Cyclocyclone/OpticniHRM/Poročilo/oscilator.png

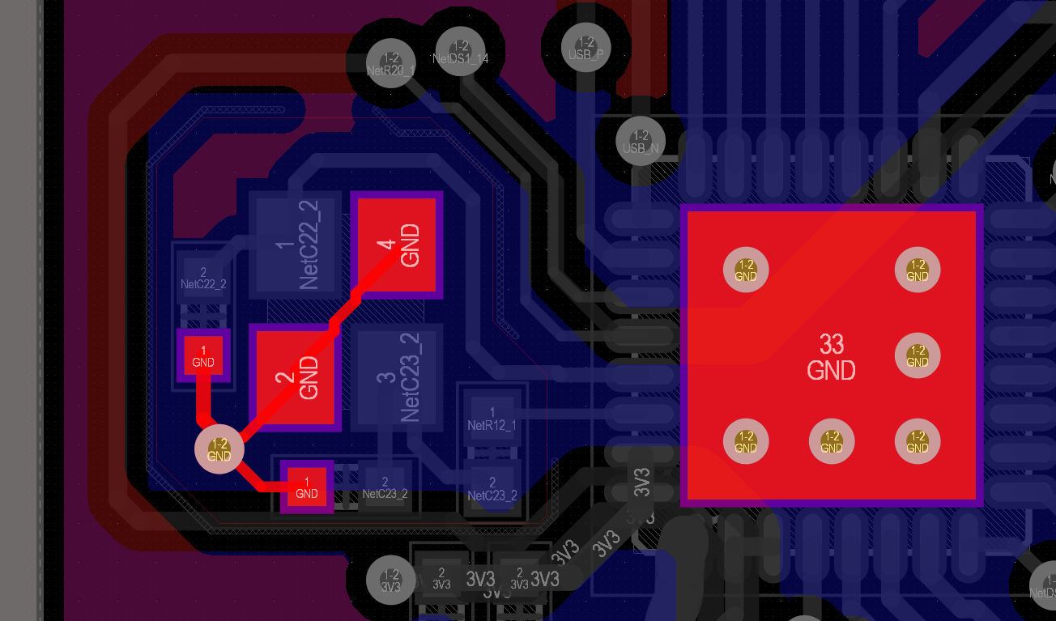
Poročilo/oscilator.png
