Cyclocyclone/OpticniHRM/Poročilo/OHRMPrincip.jpg

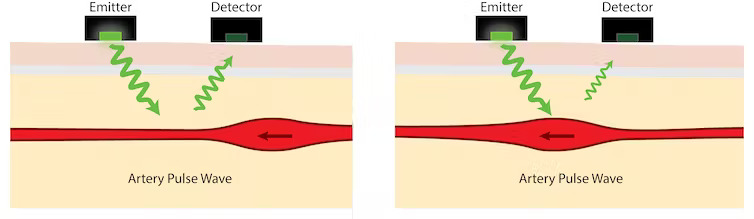
Poročilo/OHRMPrincip.jpg
