Cyclocyclone/OpticniHRM/README.md

# OpticniHRM
Wearable HRM in SpO2 monitor z prikazom na E-ink zaslonu in moznostjo povezave preko BT in WiFi.
