Cyclocyclone/OpticniHRM/Poročilo/MeritveKolo.pdf

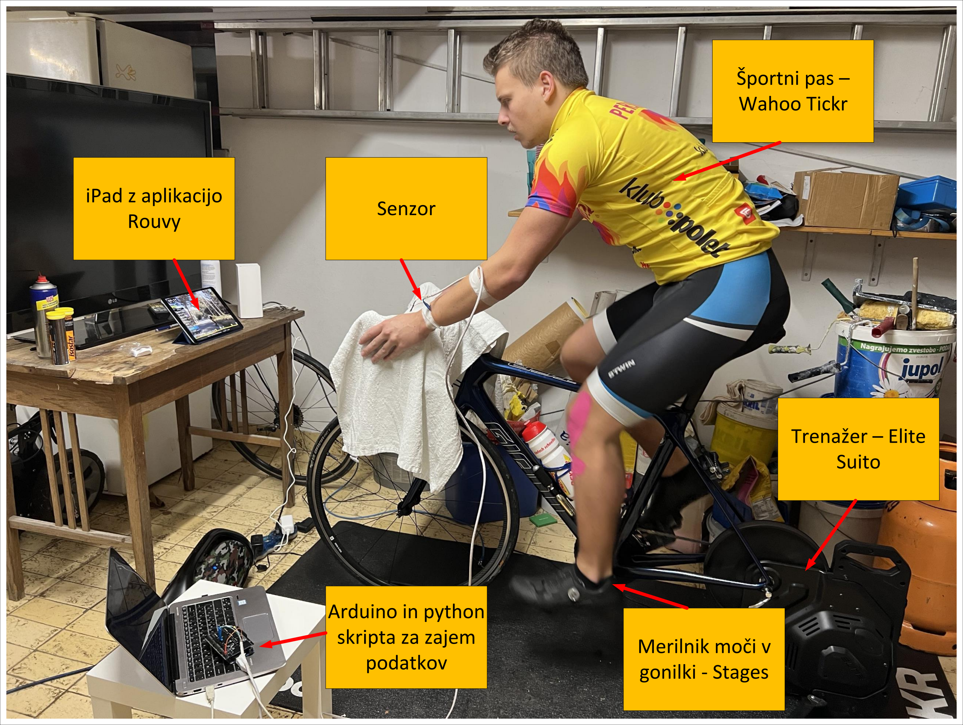
[picture p3: page 1]

Trenažer – Elite
Suito

Merilnik moči v
gonilki - Stages

Senzor

Športni pas –
Wahoo Tickr

Arduino in python
skripta za zajem
podatkov

iPad z aplikacijo
Rouvy
