Cyclocyclone/OpticniHRM/Poročilo/Blokshema.pdf

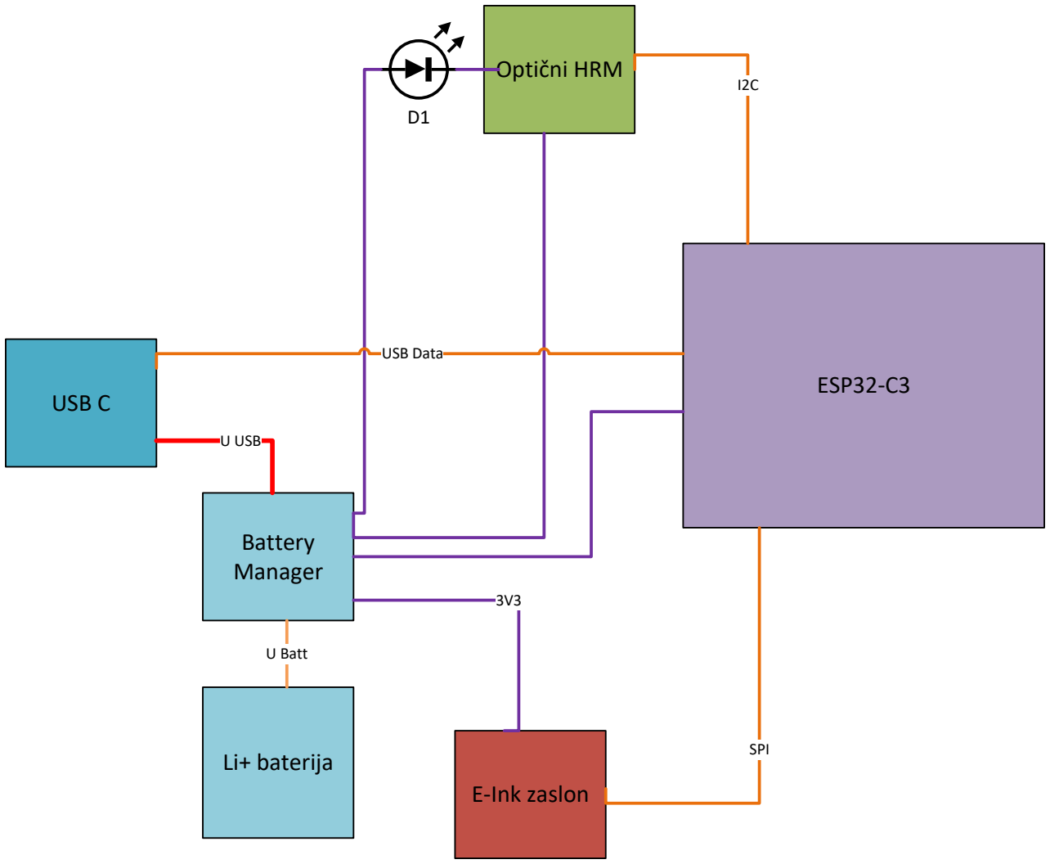
[picture p4: figure]
USB C; ESP32-C3; Battery Manager; E-Ink zaslon; Optični HRM; U USB; Li+ baterija; U Batt; USB Data; SPI
