Cyclocyclone/OpticniHRM/PythonKoda/images/fig1.pdf

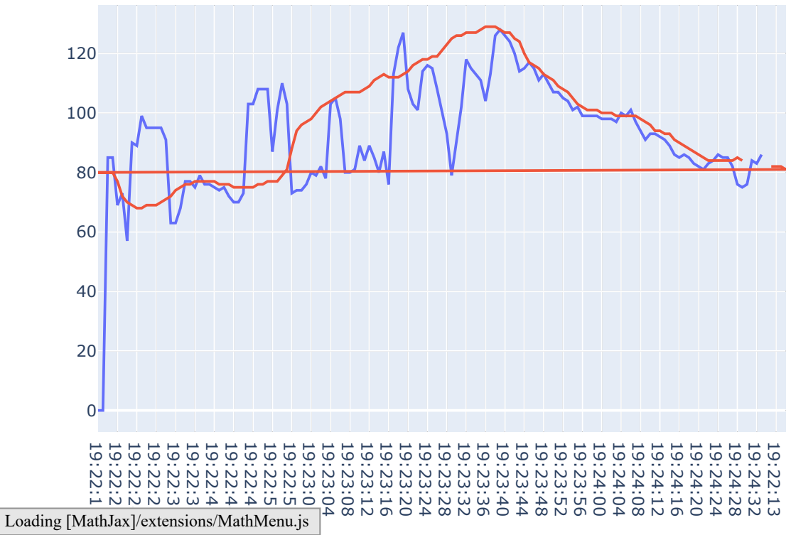
[picture p5: figure]
Loading [MathJax]/extensions/MathMenu.js

OHRM
Pas

## Primerjava senzorjev
