Cyclocyclone/OpticniHRM/PythonKoda/images/Roka.pdf

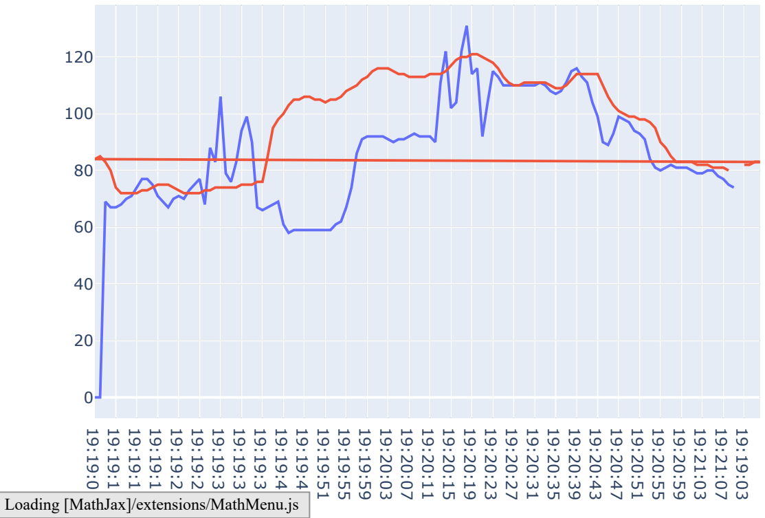
[picture p6: figure]
Loading [MathJax]/extensions/MathMenu.js

OHRM
Pas

## Senzor in pas na roki
