Cyclocyclone/OpticniHRM/PythonKoda/images/Zapestje.pdf

Loading [MathJax]/extensions/MathMenu.js

OHRM
Pas

## Senzor in pas na zapestju
