Cyclocyclone/OpticniHRM/Poročilo/antena.png

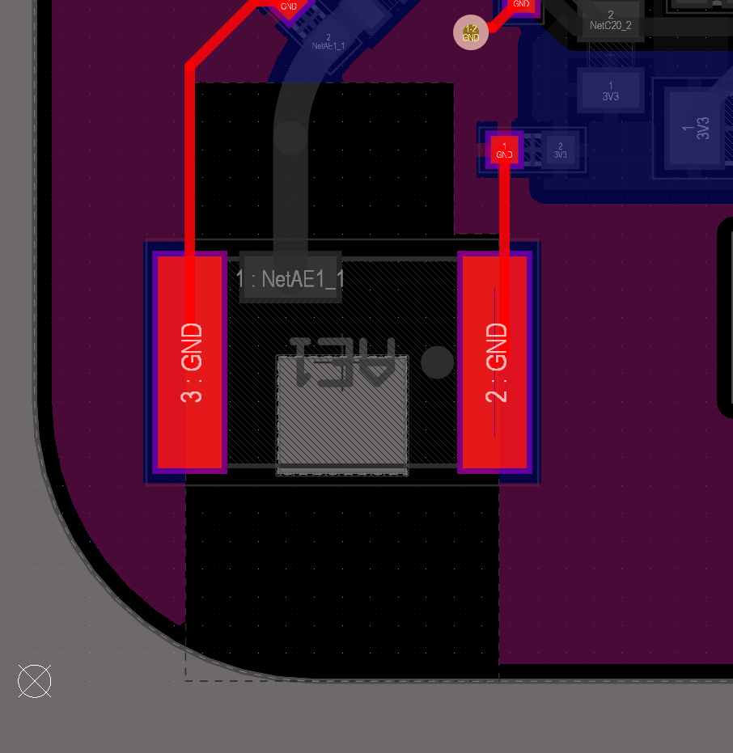
Poročilo/antena.png
