Cyclocyclone/OpticniHRM/Poročilo/DimenzijePCB.png

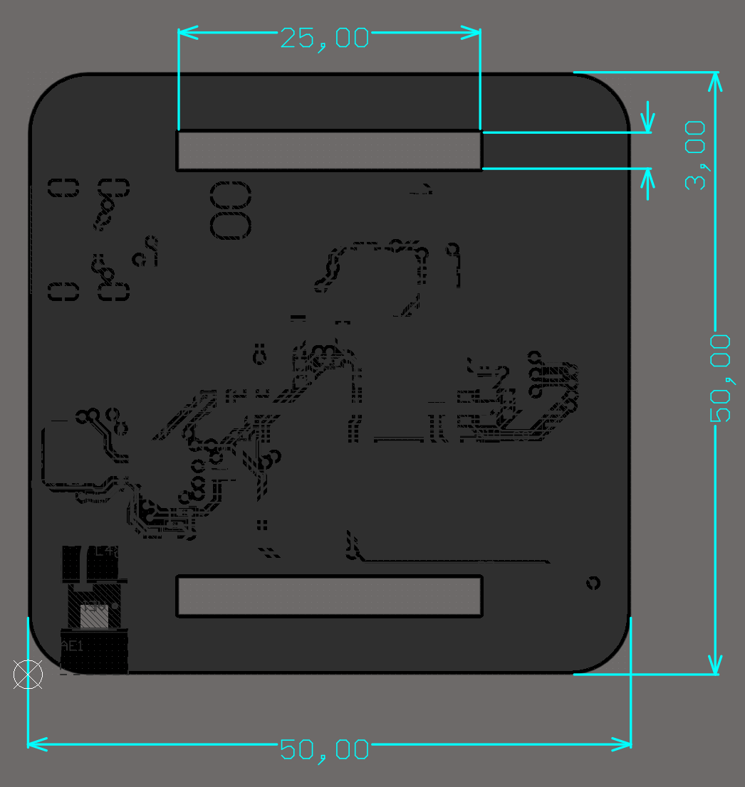
Poročilo/DimenzijePCB.png
