Cyclocyclone/OpticniHRM/Poročilo/DIsplayPSU.png

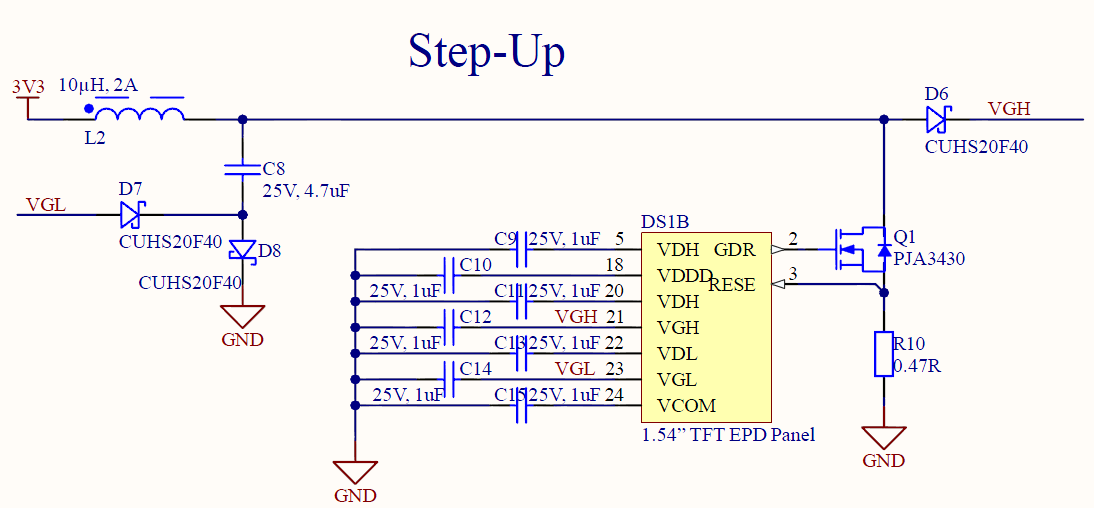
Poročilo/DIsplayPSU.png
