Cyclocyclone/OpticniHRM/Poročilo/imedancecontroled.png

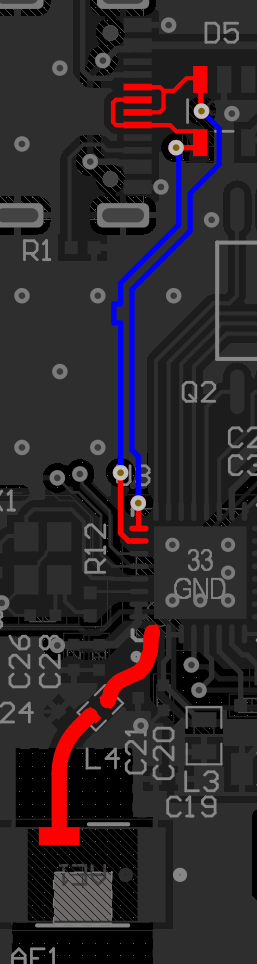
Poročilo/imedancecontroled.png
