Cyclocyclone/OpticniHRM/Poročilo/LokacijaSenzor.png

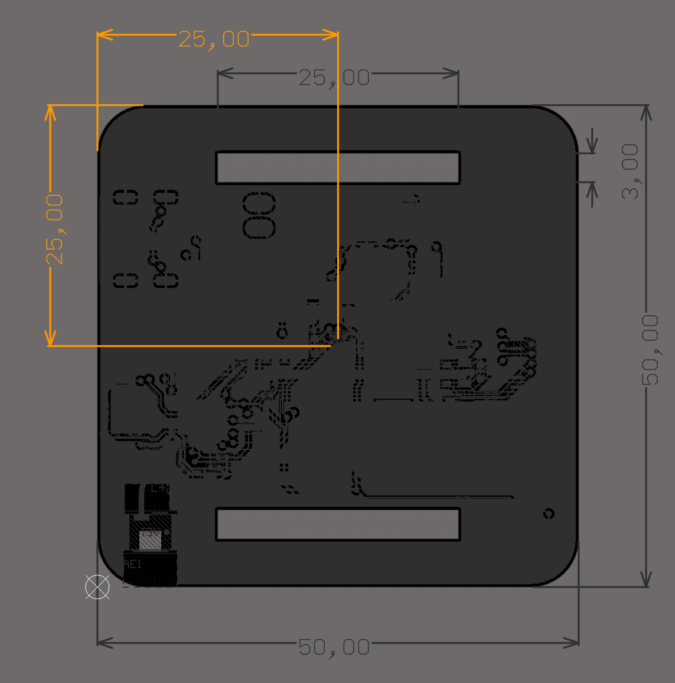
Poročilo/LokacijaSenzor.png
