Cyclocyclone/OpticniHRM/Poročilo/PSU.png

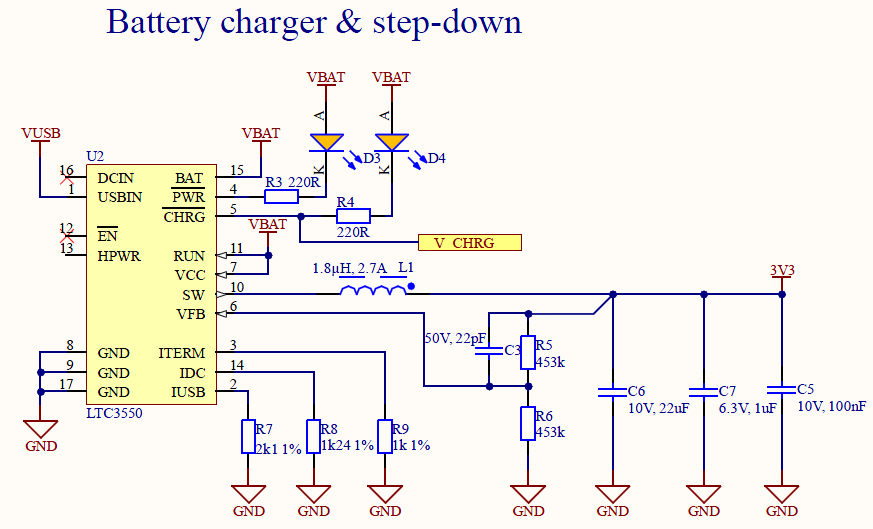
Poročilo/PSU.png
