Cyclocyclone/OpticniHRM/Poročilo/senzor.png

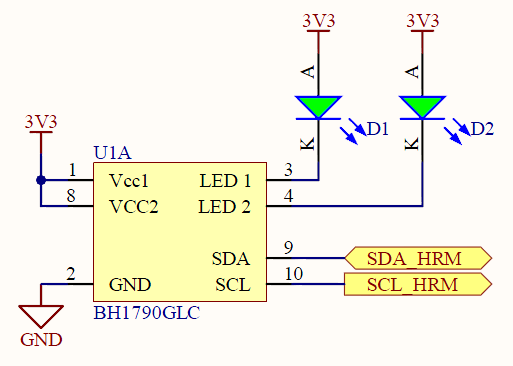
Poročilo/senzor.png
