Cyclocyclone/OpticniHRM/Poročilo/Trenazer.png

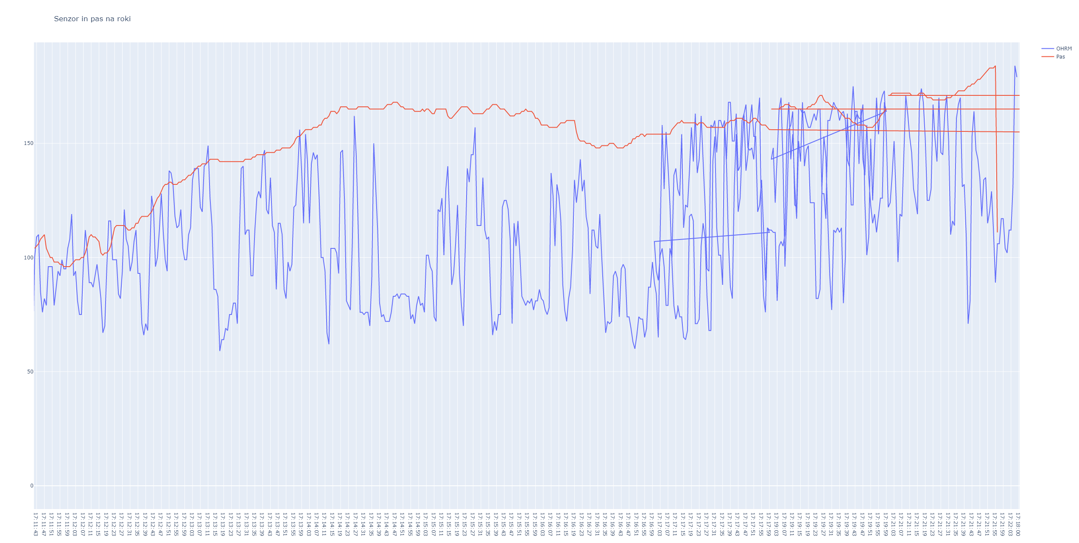
Poročilo/Trenazer.png
