Cyclocyclone/OpticniHRM/Poročilo/Varnost.png

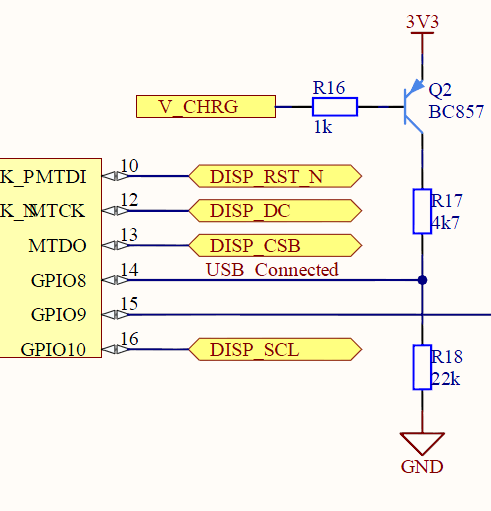
Poročilo/Varnost.png
