Cyclocyclone/OpticniHRM/Opticni HRM/Project Outputs for Opticni HRM/Opticni HRM.xlsx

Comment | Description | Designator | Footprint | LibRef | Quantity | Value | Mouser Code | Farnell code
7488960245 | WE-MCA SMT Multilayer Chip Antenna, 1 Band, 2400-2500MHz, 50Ω | AE1 | 7488960245 | 7488960245 | 1 |  | 710-7488960245
Battery To be changed |  | B1 | letev2 | header2 | 1
16V, 100nF | WCAP-CSGP Ceramic Capacitors, 0603, X7R, 16V, 100nF | C1 | 0603_1.6x0.8x0.8mm_Reflow Soldering | 885012206046 | 1 | 100nF | 710-885012206046
10V, 2.2uF | WCAP-CSGP Ceramic Capacitors, 0603, X7R, 10V, 2.2uF | C2 | 0603_1.6x0.8x0.8mm_Reflow Soldering | 885012206027 | 1 | 2.2uF | 710-885012206027
50V, 22pF | WCAP-CSGP Ceramic Capacitors, 0402, NP0, 50V, 22pF | C3 | 0402_1x0.5x0.5mm | 885012005057 | 1 | 22pF | 710-885012005057
10V, 4.7uF | WCAP-CSGP Ceramic Capacitors, 0603, X5R, 10V, 4.7uF | C4 | 0603_1.6x0.8x0.8mm_Reflow Soldering | 885012106012 | 1 | 4.7uF | 710-885012106012
10V, 100nF | WCAP-CSGP Ceramic Capacitors, 0603, X7R, 10V, 100nF | C5 | 0603_1.6x0.8x0.8mm_Reflow Soldering | 885012206020 | 1 | 100nF | 710-885012206020
10V, 22uF | WCAP-CSGP Ceramic Capacitors, 0805, X5R, 10V, 22uF | C6, C18 | 0805_2x1.25x1.25mm_Reflow Soldering | 885012107011 | 2 | 22uF | 710-885012107011
6.3V, 1uF | WCAP-CSGP Ceramic Capacitors, 0603, X5R, 6.3V, 1uF | C7 | 0603_1.6x0.8x0.8mm_Reflow Soldering | 885012106003 | 1 | 1uF | 710-885012106003
25V, 4.7uF | WCAP-CSGP Ceramic Capacitors, 0805, X5R, 25V, 4.7uF | C8 | 0805_2x1.25x1.25mm_Reflow Soldering | 885012107018 | 1 | 4.7uF | 710-885012107018
25V, 1uF | WCAP-CSGP Ceramic Capacitors, 0603, X5R, 25V, 1uF | C9, C10, C11, C12, C13, C14, C15, C16 | 0603_1.6x0.8x0.8mm_Reflow Soldering | 885012106022 | 8 | 1uF | 710-885012106022
25V, 100nF | WCAP-CSGP Ceramic Capacitors, 0402, X5R, 25V, 100nF | C17, C19, C20, C25, C27, C29 | 0402_1x0.5x0.5mm | 885012105018 | 6 | 100nF | 710-885012105018
TBD | WCAP-CSGP Ceramic Capacitors, 0402, NP0, 16V, 2.2pF | C21, C22, C23, C24 | 0402_1x0.5x0.5mm | 885012005021 | 4 | 2.2pF | 710-885012005021
10V, 1uF | WCAP-CSGP Ceramic Capacitors, 0402, X5R, 10V, 1uF | C26, C30 | 0402_1x0.5x0.5mm | 885012105012 | 2 | 1uF | 710-885012105012
10V, 10nF | WCAP-CSGP Ceramic Capacitors, 0402, X7R, 10V, 10nF | C28 | 0402_1x0.5x0.5mm | 885012205012 | 1 | 10nF | 710-885012205012
Bright Green, 2V, 140° | WL-SMCW Mono-color Chip LED Waterclear, SMT, size 0603, Bright Green, 2V, 140° | D1, D2 | WL-SMCW_0603_150060xx75003 | 150060VS75003 | 2 |  | 710-150060VS75003
Amber, 2V, 140° | WL-SMCW Mono-color Chip LED Waterclear, SMT, size 0603, Amber, 2V, 140° | D3, D4 | WL-SMCW_0603_150060xx75000 | 150060AS75000 | 2 |  | 710-150060AS75000
5V | WE-TVS TVS Diode – High Speed Series, SOT23-5L, 2+1 Channel, 5V, 2pF | D5 | WE-TVS_SOT23-5L | 824011 | 1 |  | 710-824011
CUHS20F40 | Schottky Barrier Diode Silicon Epitaxia | D6, D7, D8 | Topshiba US2H | CUHS20F40 | 3 |  | 757-CUHS20F40H3F
Green, 3.2V, 140° | WL-SMCW Mono-color Chip LED Waterclear, SMT, size 0603, Green, 3.2V, 140° | D9 | WL-SMCW_0603_150060xx75003 | 150060GS75003 | 1 |  | 710-150060GS75003
1.54” TFT EPD Panel | Wurth 687124183622 connector | DS1 | 687124183622 | E2154CS0C1 | 1 |  | 341-E2154CS0C1
USB C connector | USB4105-15-A-120 | J1 | USB4105-15-A-120 | USB4105-15-A-120 | 1 |  | 640-USB4105-GF-A
1.8µH, 2.7A | WE-TPC SMT Tiny Power Inductor, 4828, 1.8µH, 2.7A, 25mΩ | L1 | WE-TPC_4828 | 7440430018 | 1 |  | 710-7440430018
10µH, 2A | WE-TPC SMT Tiny Power Inductor, 8020, 10µH, 2A, 94mΩ | L2 | WE-TPC_8020 | 7440700100 | 1 |  | 710-7440700100
2nH, 1.9A |  | L3 | 0603CT SERIES | 0603CT-2N0XJRW | 1 |  | 994-0603CT-2N0XJRW
TBD | 0402 Coil - Coilcraft | L4 | 0402CS SERIES | 0402CT | 1
PJA3430 | 20V/2A N-Channel Enhancment Mode MOSFET | Q1 | SOT23 | PJA3430_R1_00001 | 1 |  | 241-PJA3430_R1_00001
BC857 |  | Q2 | SOT23 | BC857 | 1 |  | 771-BC857BMB315
Res2-smd |  | R1, R2 | R0402 | Res2-smd | 2 | 36k | 667-ERJ-2RKF3602X
220R |  | R3, R4, R20 | R0402 | Res 0402 | 3 | 220R | 71-CRCW0402220RFKEDC
Res2-smd |  | R5, R6 | R0402 | Res2-smd | 2 | 453k | 660-RK73H1ETTP4533F
Res2-smd |  | R7 | R0402 | Res2-smd | 1 | 2k1 1% | 652-CR0402-FX2101GLF
Res2-smd |  | R8 | R0402 | Res2-smd | 1 | 1k24 1% | 652-CR0402-FX1241GLF
Res2-smd |  | R9, R16 | R0402 | Res2-smd | 1 | 1k 1% | 603-RC0402FR-101KL
Res2-smd |  | R10 | RES0805_1 | Res2-smd | 1 | 0.47R | 667-ERJ-U6QFR47V
10k |  | R11, R13, R14, R15, R19 | R0402 | Res 0402 | 5 | 10k | 603-AC0402FR-7W10KL
TBD |  | R12 | R0402 | Res 0402 | 1
4k7 |  | R17 | R0402 | Res 0402 | 1 | 4k7 | 603-RC0402FR-7D4K7L
22k |  | R18 | R0402 | Res 0402 | 1 | 22k | 71-CRCW0402-22K-E3
435151014845 | WS-TASV SMT Tact Switch with ground terminal, SPST-NO, 12VDC, 50mA, 450g | SW1 | WS-TASV_L3W2.6H1.4_4351x10148xx | 435151014845 | 1 |  | 710-435151014845
BH1790GLC | Optical Sensor for Heart Rate Monitor IC | U1 | WLGA010V28_ROHM | BH1790GLC | 1 |  | 755-BH1790GLC-E2
LTC3550 | Dual Input USB/AC Adapter Li-Ion Battery Charger with 600mA Buck Converter | U2 | DHC16 Linear | LTC3550 | 1 |  | 584-LTC3550EDHC-1PBF
ESP32-C3 | Ultra-Low-Power SoC with RISC-V Single-Core CPU Supporting IEEE 802.11b/g/n (2.4 GHz Wi-Fi) and Bluetooth® 5 (LE) | U3 | 32L SLP Expressif | ESP32-C3 | 1 |  | 356-ESP32-C3FN4
AT25SF041B | 4-Mbit SPI Serial Flash Memory with Dual-I/O and Quad-I/O Support | U4 | SOIC8 Wide dialog semi | AT25SF041B | 1
ECX-2236B2 | ECX-2236B2 SMD CRYSTAL 40MHz +-10ppm | X1 | 2.5 x 2.0 mm XTAL | ECX-2236B2 | 1 |  | ECS-250-10-36B2-JTM-TR
 | Display connector |  |  |  |  |  | 710-686124183822
