Cyclocyclone/OpticniHRM/3D Model/Display.STEP

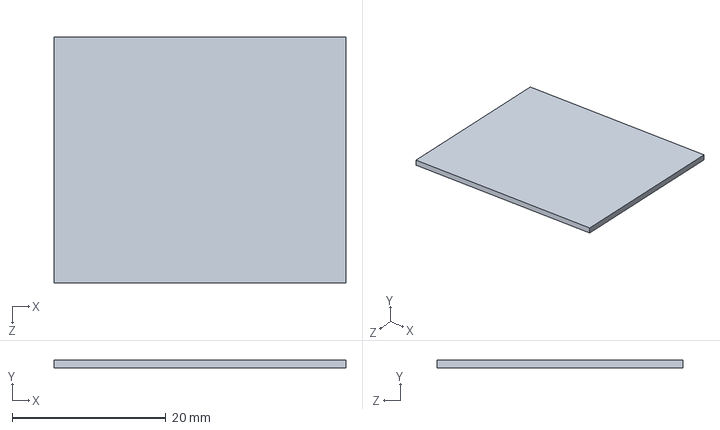
[picture p16: CAD file, 2022-11-28]
3D Model/Display.STEP
38.0 x 1.00 x 32.0 mm
