Cyclocyclone/OpticniHRM/3D Model/HRMPCB.STEP

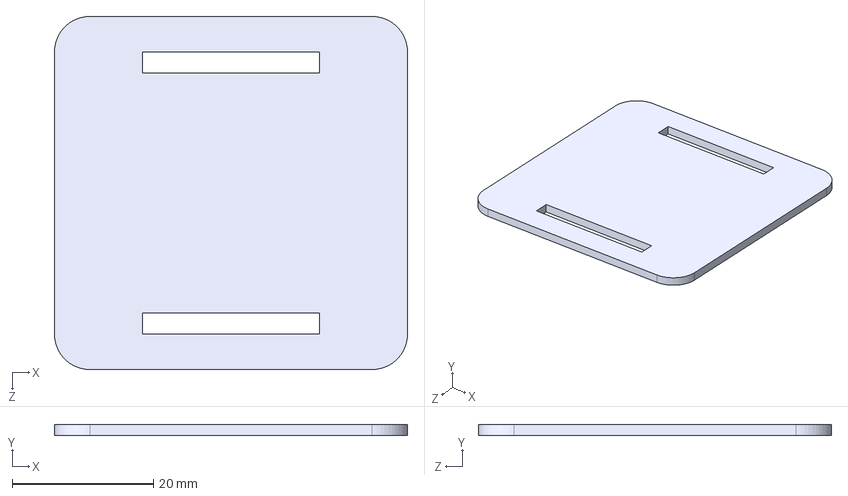
[picture p17: CAD file, 2022-11-28]
3D Model/HRMPCB.STEP
50.0 x 1.60 x 50.0 mm
