Cyclocyclone/OpticniHRM/(list of files, cad)

Other CAD files:
3D Model/HRM.SLDASM
3D Model/Display.SLDPRT
3D Model/HRMPCB.SLDPRT
3D Model/HRMPCB.STL
