Cyclocyclone/OpticniHRM/Opticni HRM/Opticni HRM.pdf

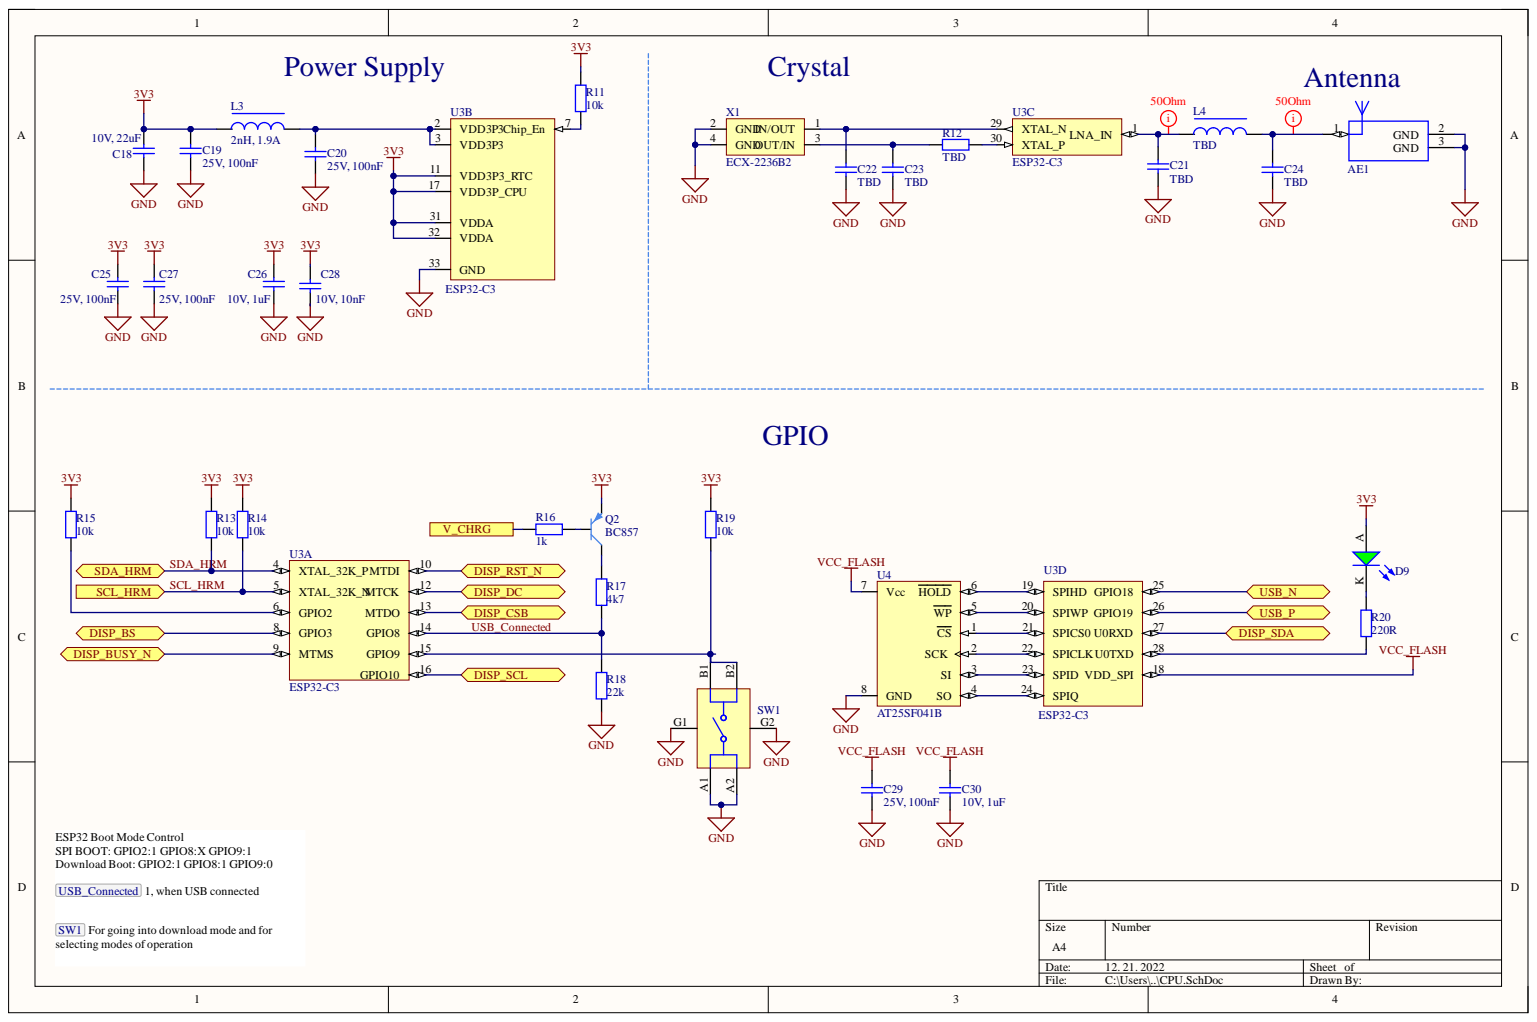
[picture p18: page 1]

VDD3P_CPU 17

VDDA 31
VDDA 32

SW1 For going into download mode and for
selecting modes of operation

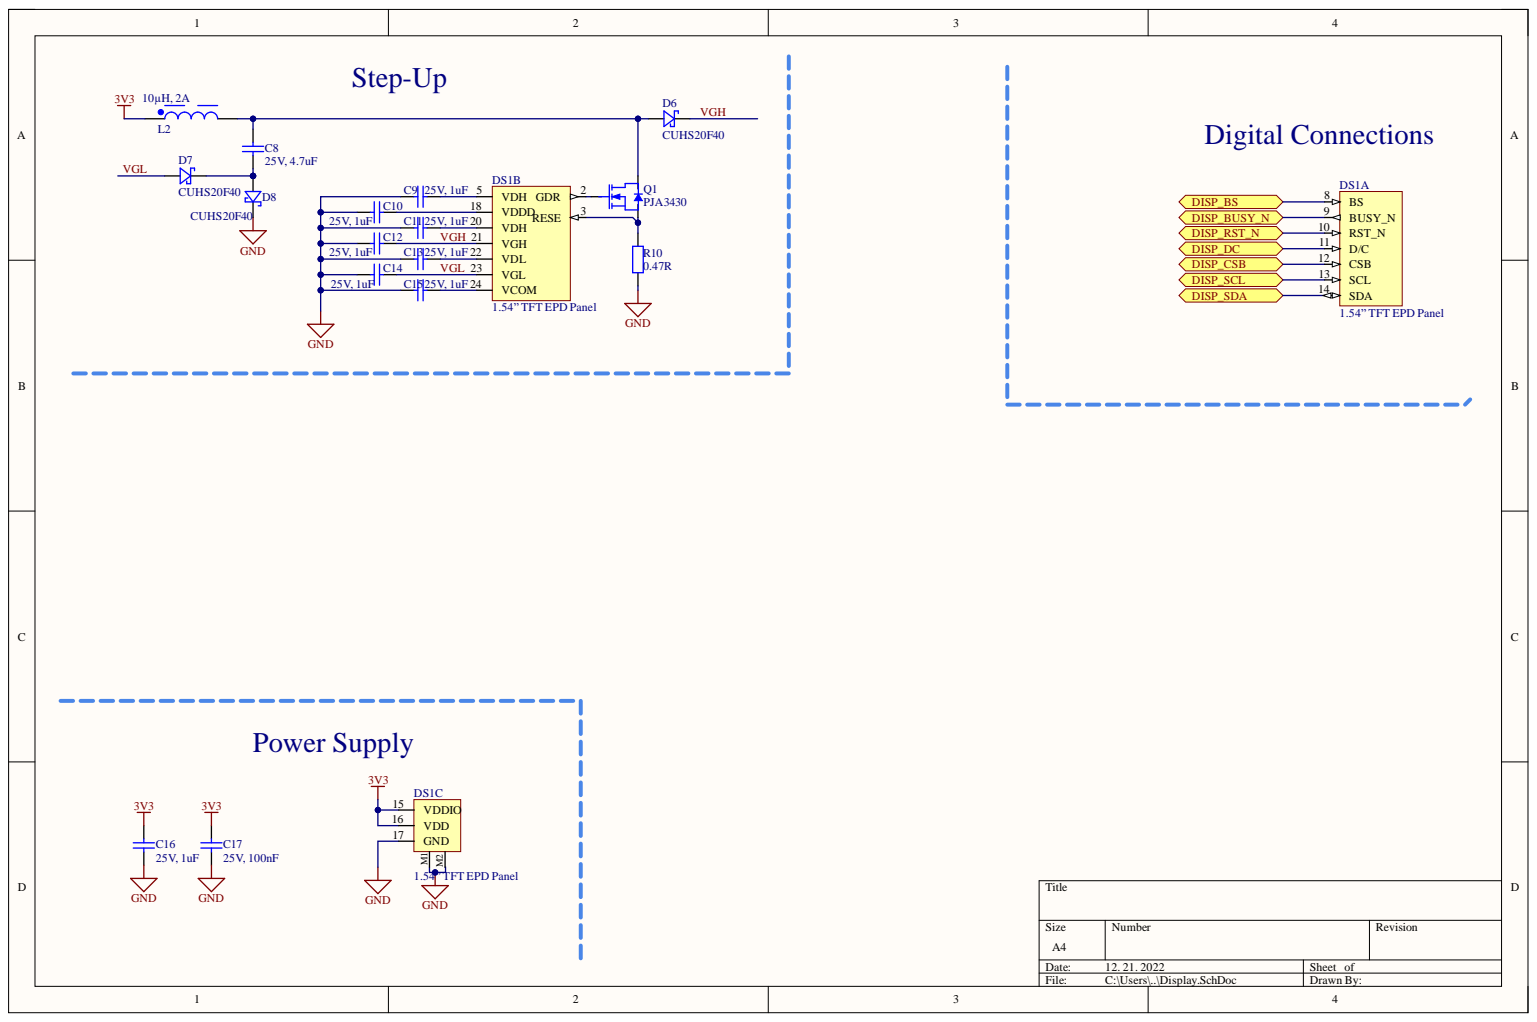
[picture p19: page 2]

C10 | | VDDD 18

25V, 1uF | C11 25V, 1uF | | VDH 20

C12 | VGH | VGH 21

25V, 1uF | C1325V, 1uF | | VDL 22

C14 | VGL | VGL 23

25V, 1uF | C1525V, 1uF | | VCOM 24

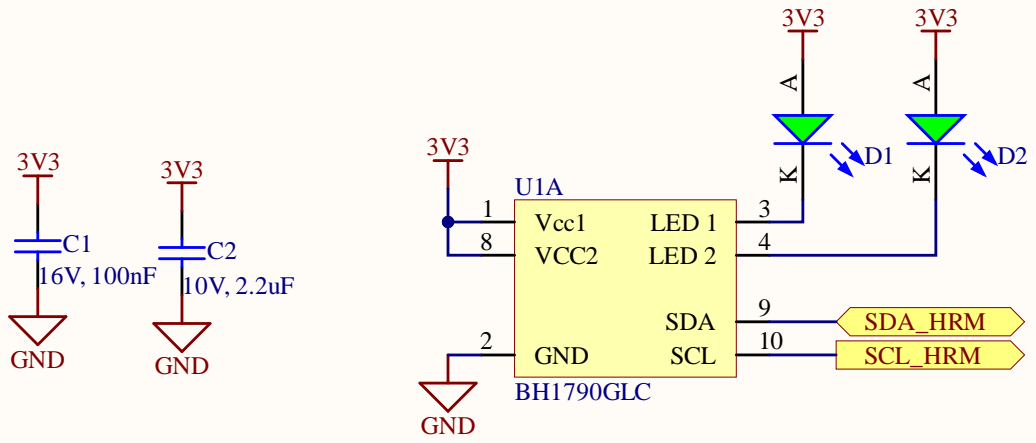
[picture p20: page 3]

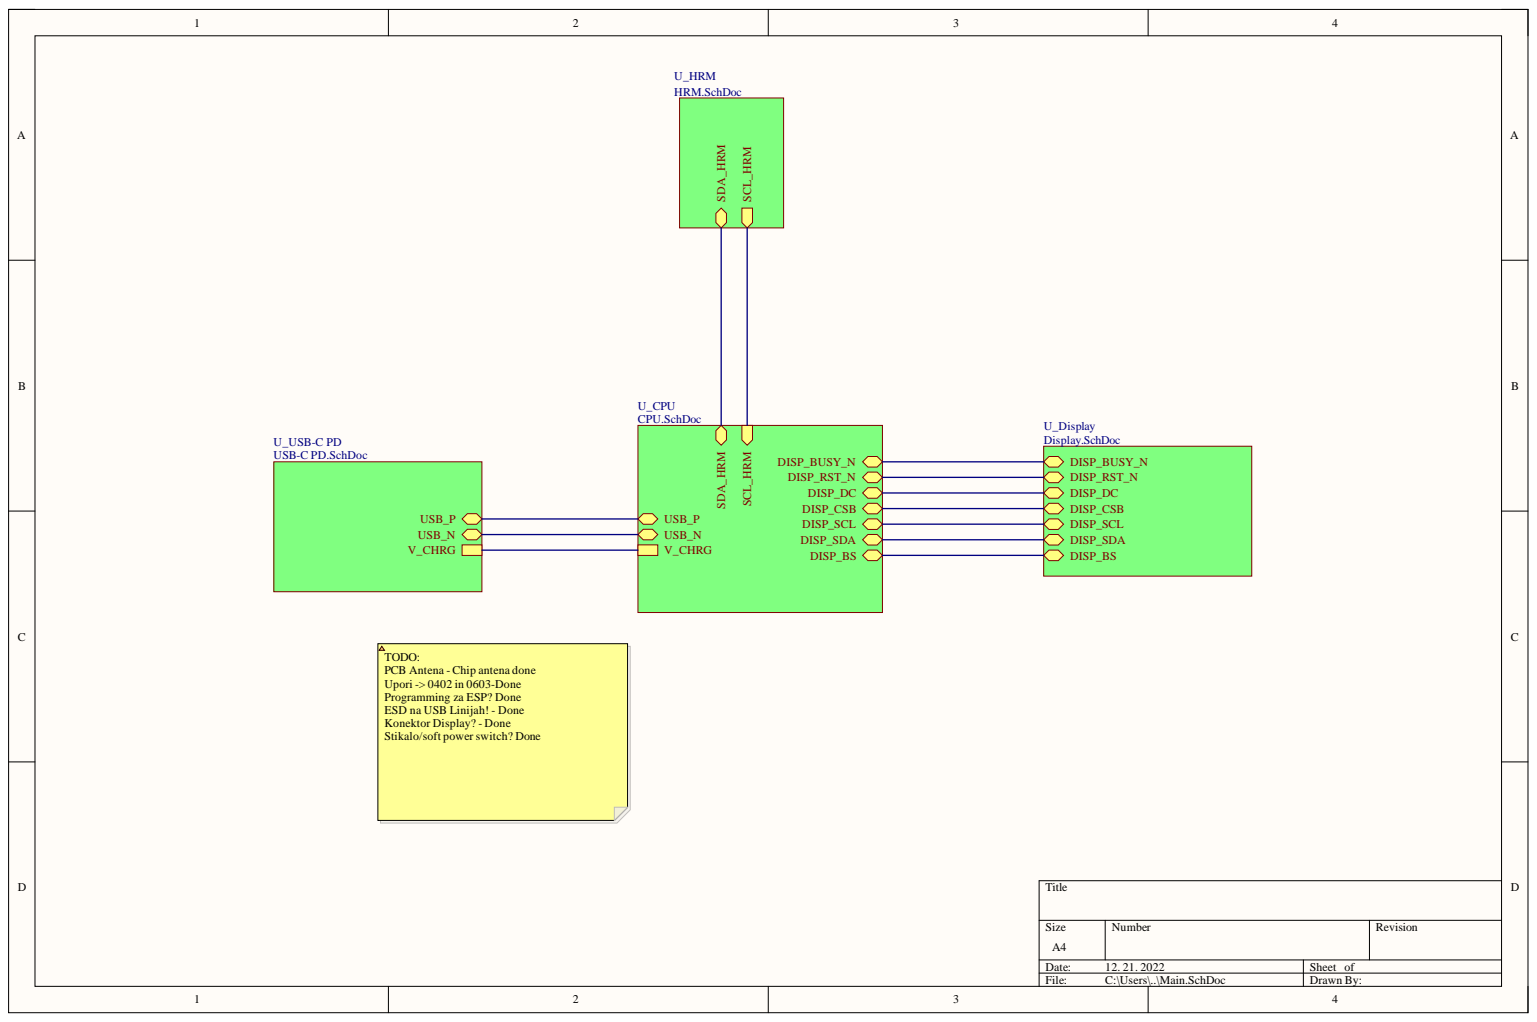
[picture p21: page 4]

TODO:
PCB Antena - Chip antena done
Upori -> 0402 in 0603-Done
Programming za ESP? Done
ESD na USB Linijah! - Done
Konektor Display? - Done
Stikalo/soft power switch? Done

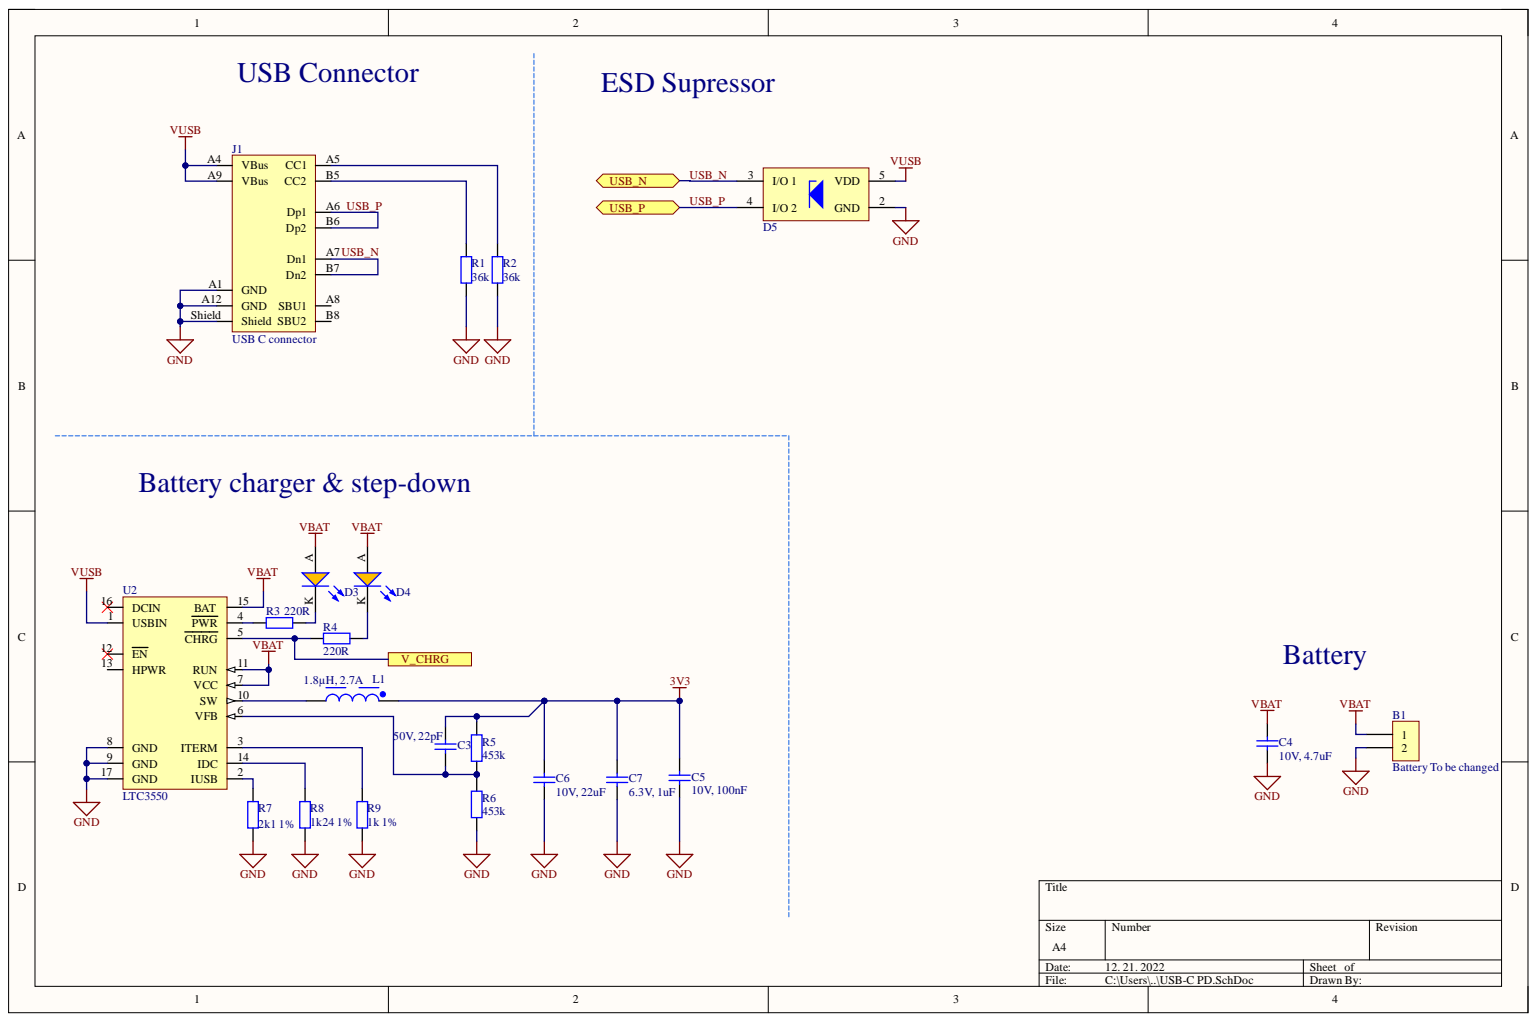
[picture p22: page 5]

Battery charger & step-down

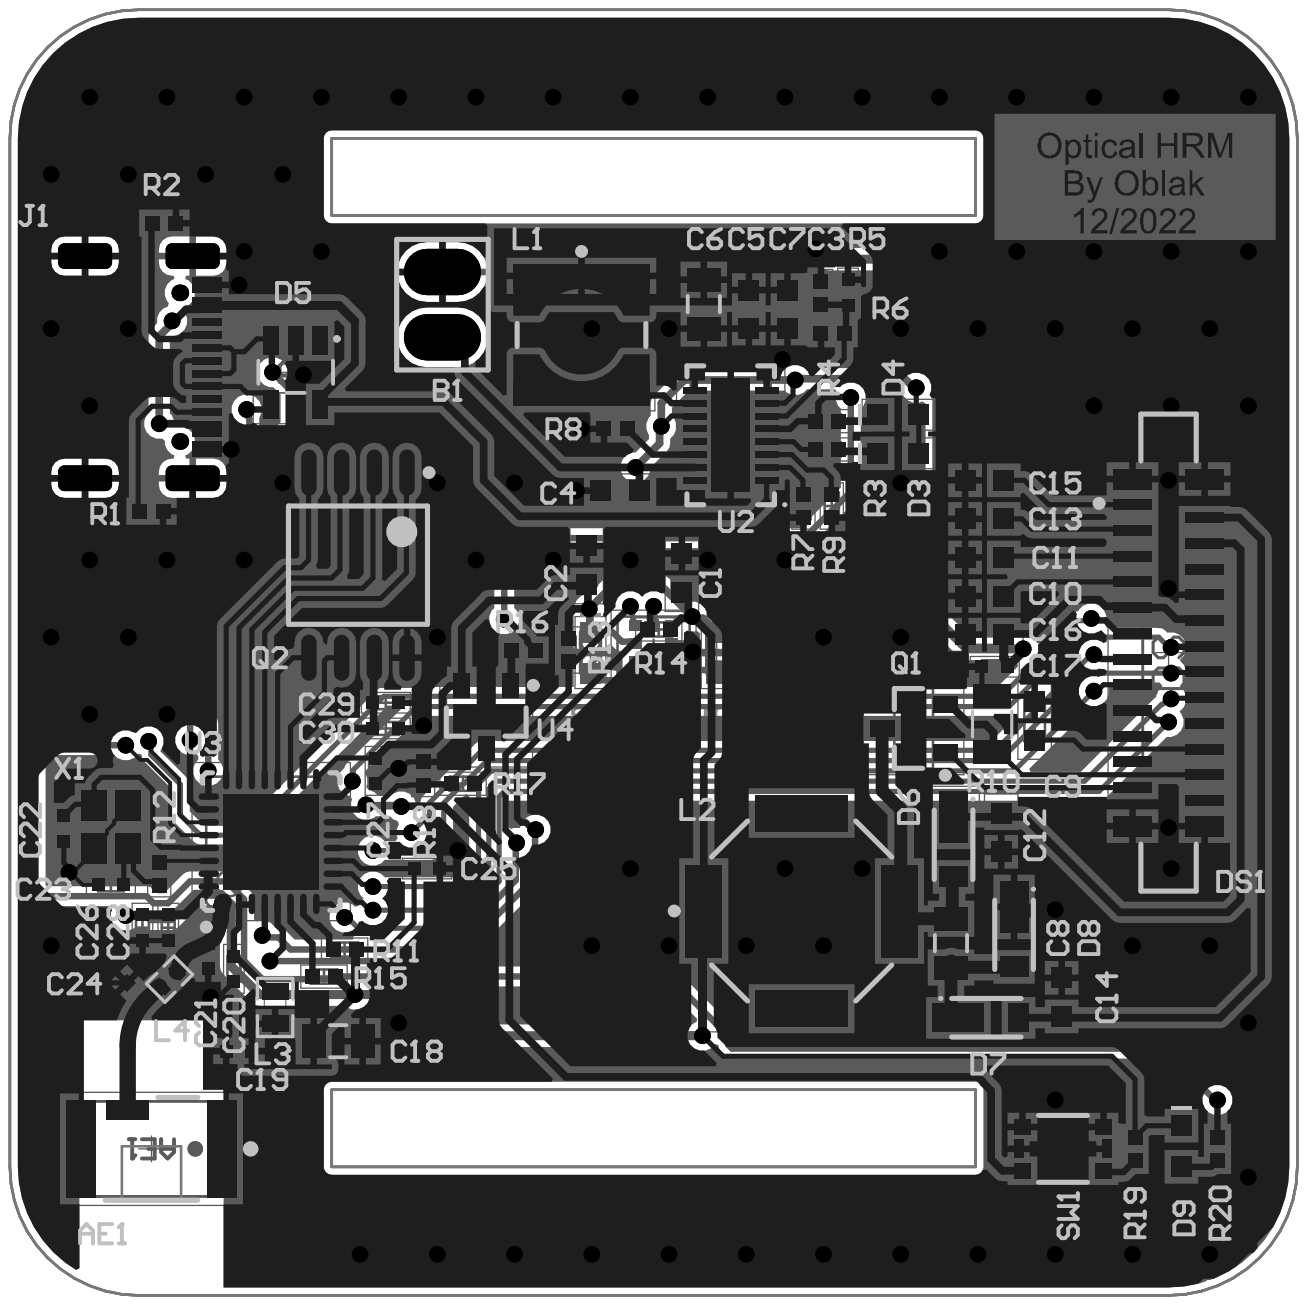
[picture p23: page 6]
