Cyclocyclone/OpticniHRM/PythonKoda/images/Trenazer.pdf

## Senzor in pas na roki

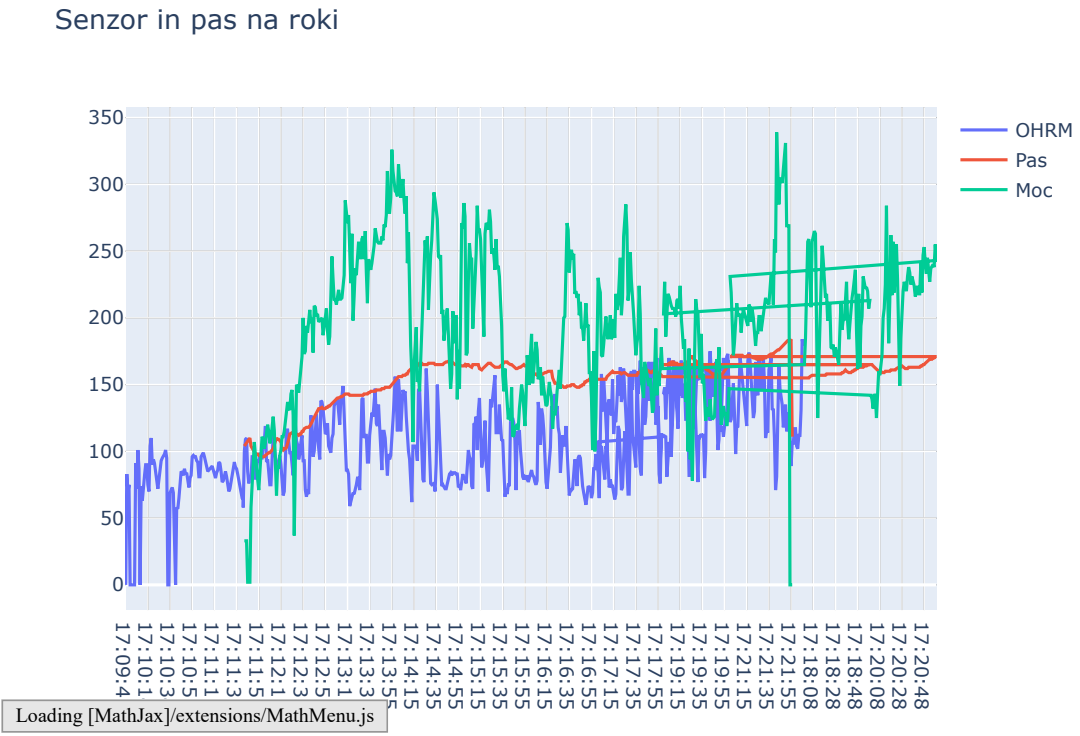
[picture p24: page 1]
OHRM; Pas Moc

Loading [MathJax]/extensions/MathMenu.js
