Cyclocyclone/OpticniHRM/(list of files, drawings)

Other design files:
Opticni HRM/CPU.SchDoc
Opticni HRM/Display.SchDoc
Opticni HRM/HRM.SchDoc
Opticni HRM/HRM_0.1.PcbDoc
Opticni HRM/Main.SchDoc
Opticni HRM/Opticni HRM.PrjPcb
Opticni HRM/USB-C PD.SchDoc
PcbLib1.PcbLib
Schlib1.SchLib
