Cyclocyclone/OpticniHRM/STMProjekt/Core/Src/main.c

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
/* Includes ------------------------------------------------------------------*/
#include "main.h"

/* USER CODE BEGIN PD */
#define BH1790ADDR 0x9B

#define BH1790_W1 0x4180
#define BH1790_W2 0x4200
#define BH1790_W3 0x4301

#define BH1790_R1 0x5400
#define BH1790_R2 0x5500
#define BH1790_R3 0x5600
#define BH1790_R4 0x5700
/* USER CODE END PD */

I2C_HandleTypeDef hi2c1;

UART_HandleTypeDef huart1;

void SystemClock_Config(void);
static void MX_GPIO_Init(void);
static void MX_I2C1_Init(void);
static void MX_USART1_UART_Init(void);
/**
  * @brief  The application entry point.
  * @retval int
  */
int main(void)
{
  /* MCU Configuration--------------------------------------------------------*/

  /* Reset of all peripherals, Initializes the Flash interface and the Systick. */
  HAL_Init();

  /* Configure the system clock */
  SystemClock_Config();

  /* Initialize all configured peripherals */
  MX_GPIO_Init();
  MX_I2C1_Init();
  MX_USART1_UART_Init();
  /* USER CODE BEGIN 2 */
  buf[0] = BH1790_W1;
  ret = HAL_I2C_Master_Transmit(&hi2c1, BH1790ADDR, buf, 2 HAL_MAX_DELAY);
  ret = HAL_I2C_Master_Transmit(&hi2c1, BH1790ADDR, BH1790_W2, 2 HAL_MAX_DELAY);
  ret = HAL_I2C_Master_Transmit(&hi2c1, BH1790ADDR, BH1790_W3, 2 HAL_MAX_DELAY);
  /* USER CODE END 2 */

  /* Infinite loop */
  /* USER CODE BEGIN WHILE */
  while (1)
  {
    /* USER CODE END WHILE */
	  ret = HAL_I2C_Master_Receive(&hi2c1, BH1790ADDR, BH1790_R1, 2 HAL_MAX_DELAY);
	  ret = HAL_I2C_Master_Receive(&hi2c1, BH1790ADDR, BH1790_R1, 2 HAL_MAX_DELAY);
	  ret = HAL_I2C_Master_Receive(&hi2c1, BH1790ADDR, BH1790_R1, 2 HAL_MAX_DELAY);
    /* USER CODE BEGIN 3 */
  }
  /* USER CODE END 3 */
}

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
