Cyclocyclone/OpticniHRM/ESP_Koda/OHRM_0.1/src/main.c

//Outputs
#define SIG_LED PIN21

//Inputs
#define USB_CONNECTED PIN8
#define USER_BUTTON PIN9

//Display:
//Out:
#define DISP_BS PIN3
#define DISP_RST_N PIN5
#define DISP_DC PIN6
#define DISP_CSB PIN7
//In:
#define DISP_BUSY_N PIN4
//SPI
#define DISP_SCL PIN10
#define DISP_SDA PIN20

//HRM I2C:
#define HRM_SDA PIN0
#define HRM_SCL PIN1

//USB:
#define USB_N PIN18
#define USB_P PIN19




void app_main() {}
