Cyclocyclone/OpticniHRM/(commit log)

2022-10-17 Rohm senzor
    [PcbLib1.PcbLib, Schlib1.SchLib]
2022-10-18 Verzija 0.1
    [CPU.SchDoc, Display.SchDoc, HRM.SchDoc, Main.SchDoc, Opticni HRM.PrjPcb, USB-C PD.SchDoc]
2022-10-18 Shema
    Shema semi koncana, zacetek PCB
    [CPU.SchDoc, Display.SchDoc, HRM.SchDoc, HRM_0.1.PcbDoc, Main.SchDoc, Opticni HRM.PrjPcb, USB-C PD.SchDoc]
2022-10-19 V0.1
    Shema 95% fertig pcb 30% ferig
    [CPU.SchDoc, Display.SchDoc, HRM_0.1.PcbDoc, Main.SchDoc, Opticni HRM.PrjPcb, USB-C PD.SchDoc]
2022-11-28 Pcb kr dost narejn
    [CPU.SchDoc, Display.SLDPRT, Display.STEP, Display.SchDoc, HRM.SLDASM, HRMPCB.SLDPRT, HRMPCB.STEP, HRMPCB.STL]
2022-11-29 Semi fertik
    Probat narest na 2layer
    [CPU.SchDoc, HRM.SchDoc, HRM_0.1.PcbDoc, USB-C PD.SchDoc]
2022-11-29 2 layer verzija fertik
    [Display.SchDoc, HRM_0.1.PcbDoc]
2022-12-12 Finalna verzija PCBja
    [HRM_0.1.PcbDoc]
2022-12-13 Res final PCB + stm32
    [HRM_0.1.PcbDoc]
2022-12-14 res final
    [HRM_0.1.GBL, HRM_0.1.GBO, HRM_0.1.GBP, HRM_0.1.GBS, HRM_0.1.GTL, HRM_0.1.GTO, HRM_0.1.GTP, HRM_0.1.GTS]
2022-12-14 neki neki final
    [HRM_0.1.PcbDoc]
2022-12-19 res fertik
    [HRM_0.1.GBL, HRM_0.1.GBO, HRM_0.1.GBP, HRM_0.1.GBS, HRM_0.1.GKO, HRM_0.1.GTL, HRM_0.1.GTO, HRM_0.1.GTP]
2023-01-04 Python skripte, arduino skripta
    [HRM_0.1.GBL, HRM_0.1.GBO, HRM_0.1.GBP, HRM_0.1.GBS, HRM_0.1.GTL, HRM_0.1.GTO, HRM_0.1.GTP, HRM_0.1.GTS]
2023-01-12 Koda in ostale pizdarije
    [HRMLog040123.csv, HRMLog040123cajt.csv, HRMZap.csv, HRMZapestje.csv, HRMroka.csv, HRMroka1.csv, HRMzapestje1.csv]
